ashtonchase/portable_impedance_tomography/software/ad5933/hal/README.org

* Hardware Abstraction Layer 
This folder houses the different hardware abstraction layers for device specific \(I^2C\) communication functions.
