ashtonchase/portable_impedance_tomography/documentation/final_presentation.odt

Ashton Johnson

Electrical impedance analysis is a non-invasive technique used for determining the density and composition of various materials. Regarding the human body, one dimensional analysis can determine water content, body fat, and blood glucose measurements. Using multiple electrode sets, we developed a solution to provide two dimensional (2D) tomography imaging. A portable bio-impedance tomography unit is realized using the Analog Devices AD5933 integrated circuit for measuring complex impedance, an analog front end for interfacing to the human body and analog multiplexers. We implement this as a portable device that can be accessed using Bluetooth Low Energy.
