ashtonchase/portable_impedance_tomography/documentation/report/graphics/zu.png

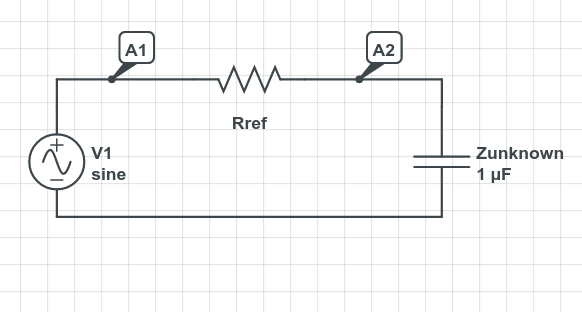
documentation/report/graphics/zu.png
