ashtonchase/portable_impedance_tomography/documentation/system_states_report/sys_diag.png

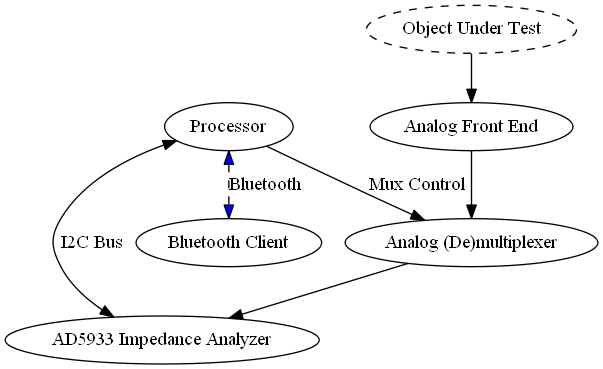
documentation/system_states_report/sys_diag.png
