ashtonchase/portable_impedance_tomography/hardware/kicad_project/portable_imedance.xlsx

Proj: | Portable Impedance Tomography |  |  |  |  |  | Board Qty: | 100
Co.: | Ashton Johnson |  |  |  |  |  | Total Cost: | $0.00 |  |  |  | $0.00 |  |  |  |  | $0.00 |  |  |  |  | $0.00 |  |  |  |  | $0.00 |  |  |  |  | $0.00 |  |  |  |  | $0.00
Date: | 2017-10-21 15:20:06 |  |  |  |  |  | Unit Cost: | $0.00 |  |  |  | 0 |  |  |  |  | 0 |  |  |  |  | 0 |  |  |  |  | 0 |  |  |  |  | 0 |  |  |  |  | 0
Global Part Info |  |  |  |  |  |  |  |  | Digi-Key |  |  |  |  | Farnell |  |  |  |  | Mouser |  |  |  |  | Newark |  |  |  |  | Rs Components |  |  |  |  | Tme
Refs | Value | Desc | Footprint | Manf | Manf# | Qty | Unit$ | Ext$ | Avail | Purch | Unit$ | Ext$ | Cat# | Avail | Purch | Unit$ | Ext$ | Cat# | Avail | Purch | Unit$ | Ext$ | Cat# | Avail | Purch | Unit$ | Ext$ | Cat# | Avail | Purch | Unit$ | Ext$ | Cat# | Avail | Purch | Unit$ | Ext$ | Cat#
C1,C2 | 0.1uF |  | Capacitors_SMD:C_0603_HandSoldering | VISHAY | VJ0603V104ZXQPW1BC | 0 | $0.00 | $0.00 |  |  |  |  |  |  |  |  |  |  | 26868 |  | $0.00 | $0.00 | 77-VJ0603V104ZXQPBC (http://www.mouser.com/Search/Refine.aspx?Keyword=VJ0603V104ZXQPW1BC%20)
C3 | 10uF |  | Capacitors_SMD:C_0603_HandSoldering | VISHAY | VJ0603V105ZXQPW1BC | 0 | $0.00 | $0.00 |  |  |  |  |  |  |  |  |  |  | 15000 |  | $0.00 | $0.00 | 77-VJ0603V105ZXQPBC (http://www.mouser.com/Search/Refine.aspx?Keyword=VJ0603V105ZXQPW1BC%20)
C5,C14,C18,C20 | 0.1u |  | Capacitors_SMD:C_0603_HandSoldering | VISHAY | VJ0603V104ZXQPW1BC | 0 | $0.00 | $0.00 |  |  |  |  |  |  |  |  |  |  | 26868 |  | $0.00 | $0.00 | 77-VJ0603V104ZXQPBC (http://www.mouser.com/Search/Refine.aspx?Keyword=VJ0603V104ZXQPW1BC%20)
C6,C10,C15,C16 | 1u |  | Capacitors_SMD:C_0603_HandSoldering | VISHAY | VJ0603V105ZXQPW1BC | 0 | $0.00 | $0.00 |  |  |  |  |  |  |  |  |  |  | 15000 |  | $0.00 | $0.00 | 77-VJ0603V105ZXQPBC (http://www.mouser.com/Search/Refine.aspx?Keyword=VJ0603V105ZXQPW1BC%20)
C8,C13 | 33n |  | Capacitors_SMD:C_0402 | VISHAY | VJ0402V333ZXQPW1BC | 0 | $0.00 | $0.00 |  |  |  |  |  |  |  |  |  |  | NonStk |  | $0.00 | $0.00 | 77-VJ0402V333ZXQPBC (http://www.mouser.com/Search/Refine.aspx?Keyword=VJ0402V333ZXQPW1BC%20)
J1-J16 | UMC |  | Connectors_Molex:Molex_Microcoaxial_RF | TE | 1909763-1 | 0 | $0.00 | $0.00 | 63580 |  | $0.00 | $0.00 | A118077CT-ND (http://www.digikey.com/product-detail/en/te-connectivity-amp-connectors/1909763-1/A118077CT-ND/4729711) | NonStk |  | $0.00 | $0.00 | 2781689 (http://it.farnell.com/webapp/wcs/stores/servlet/Search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) | 28851 |  | $0.00 | $0.00 | 571-1909763-1 (http://www.mouser.com/Search/Refine.aspx?Keyword=1909763-1%20) | NonStk |  | $0.00 | $0.00 | 62X0488 (http://www.newark.com/webapp/wcs/stores/servlet/Search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)
J17 | Conn_02x12_Odd_Even |  | Socket_Strips:Socket_Strip_Straight_2x12_Pitch2.54mm_SMD | MOLEX | 90131-0132 | 0 | $0.00 | $0.00 | NonStk |  | $0.00 | $0.00 | WM50035-24-ND (http://www.digikey.com/scripts/DkSearch/dksus.dll?WT.z_header=search_go&lang=en) |  |  |  |  |  | 777 |  | $0.00 | $0.00 | 538-90131-0132 (http://www.mouser.com/Search/Refine.aspx?Keyword=90131-0132%20) | NonStk |  | $0.00 | $0.00 | 60H4451 (http://www.newark.com/webapp/wcs/stores/servlet/Search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) | NonStk |  | $0.00 | $0.00 | 670-3477 (http://it.rs-online.com/web/c/?searchTerm=90131-0132%20)
J18 | Conn_01x03 |  |  |  | 68001-403HLF | 0 | $0.00 | $0.00 | 7623 |  | $0.00 | $0.00 | 609-3471-ND (http://www.digikey.com/scripts/DkSearch/dksus.dll?WT.z_header=search_go&lang=en) | NonStk |  |  |  | 1835553 (http://it.farnell.com/webapp/wcs/stores/servlet/Search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) | 1347 |  | $0.00 | $0.00 | 649-68001-403HLF (http://www.mouser.com/Search/../ProductDetail/Amphenol-FCI/68001-403HLF/) | 3151 |  | $0.00 | $0.00 | 56K0149 (http://www.newark.com/harwin/m20-9990346/connector-header-3-position-1row/dp/56K0149?rpsku=rel3%3A68001403HLF) | NonStk |  | $0.00 | $0.00 | 863-2747 (http://it.rs-online.com/web/c/?searchTerm=68001-403HLF%20)
J19 | Conn_02x06_Odd_Even |  | Socket_Strips:Socket_Strip_Straight_2x06_Pitch2.54mm_SMD | MOLEX | 71764-0012 | 0 | $0.00 | $0.00 | NonStk |  | $0.00 | $0.00 | WM50028-12-ND (http://www.digikey.com/scripts/DkSearch/dksus.dll?WT.z_header=search_go&lang=en) |  |  |  |  |  | 1220 |  | $0.00 | $0.00 | 538-71764-0012 (http://www.mouser.com/Search/Refine.aspx?Keyword=71764-0012%20) | NonStk |  | $0.00 | $0.00 | 01J9357 (http://www.newark.com/webapp/wcs/stores/servlet/Search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)
J20-J25 | Conn_01x02 |  | Socket_Strips:Socket_Strip_Straight_1x02_Pitch2.54mm |  | 68001-402HLF | 0 | $0.00 | $0.00 | 20294 |  | $0.00 | $0.00 | 609-3507-ND (http://www.digikey.com/scripts/DkSearch/dksus.dll?WT.z_header=search_go&lang=en) | NonStk |  | $0.00 | $0.00 | 1835033 (http://it.farnell.com/webapp/wcs/stores/servlet/Search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) | 22287 |  | $0.00 | $0.00 | 649-68001-402HLF (http://www.mouser.com/Search/../ProductDetail/Amphenol-FCI/68001-402HLF/) | NonStk |  | $0.00 | $0.00 | 75K3882 (http://www.newark.com/webapp/wcs/stores/servlet/Search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) | NonStk |  | $0.00 | $0.00 | 863-3178 (http://it.rs-online.com/web/c/?searchTerm=68001-402HLF%20)
R1,R2 | 4.7k |  | Resistors_SMD:R_0603_HandSoldering | KEMET | CRCW06034K70FKEA | 0 | $0.00 | $0.00 | NonStk |  | $0.00 | $0.00 | 541-4.70KHCT-ND (http://www.digikey.com/product-detail/en/vishay-dale/CRCW06034K70FKEA/541-4.70KHCT-ND/1179885) | NonStk |  | $0.00 | $0.00 | 1469807 (http://it.farnell.com/vishay/crcw06034k70fkea/res-film-spesso-4k7-1-0-1w-0603/dp/1469807) | NonStk |  | $0.00 | $0.00 | 71-CRCW0603-4.7K-E3 (http://www.mouser.com/Search/../ProductDetail/Vishay/CRCW06034K70FKEA/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) | NonStk |  | $0.00 | $0.00 | 52K8494 (http://www.newark.com/vishay/crcw06034k70fkea/res-thick-film-4k7-1-0-1w-0603/dp/52K8494) | 450 |  | $0.00 | $0.00 | 679-0484 (http://it.rs-online.com/web/p/resistori-smd/6790484/)
R11 | 75 |  | Resistors_SMD:R_0603_HandSoldering | KEMET | CRCW060375R0FKEA | 0 | $0.00 | $0.00 | NonStk |  | $0.00 | $0.00 | 541-75.0HCT-ND (http://www.digikey.com/product-detail/en/vishay-dale/CRCW060375R0FKEA/541-75.0HCT-ND/1179681) | NonStk |  | $0.00 | $0.00 | 1469838 (http://it.farnell.com/vishay/crcw060375r0fkea/res-film-spesso-75r-1-0-1w-0603/dp/1469838) | NonStk |  | $0.00 | $0.00 | 71-CRCW0603-75-E3 (http://www.mouser.com/Search/../ProductDetail/Vishay/CRCW060375R0FKEA/) | 692 |  | $0.00 | $0.00 | 52K8710 (http://www.newark.com/vishay/crcw060375r0fkea/res-thick-film-75r-1-0-1w-0603/dp/52K8710) | 3450 |  | $0.00 | $0.00 | 679-0699 (http://it.rs-online.com/web/p/resistori-smd/6790699/)
R12 | 10k |  | Resistors_SMD:R_0603_HandSoldering |  | CRCW060310K0FKEA | 0 | $0.00 | $0.00 | NonStk |  | $0.00 | $0.00 | 541-10.0KHCT-ND (http://www.digikey.com/product-detail/en/vishay-dale/CRCW060310K0FKEA/541-10.0KHCT-ND/1179924) | 27752 |  | $0.00 | $0.00 | 1469748 (http://it.farnell.com/vishay/crcw060310k0fkea/res-film-spesso-10k-1-0-1w-0603/dp/1469748) | NonStk |  | $0.00 | $0.00 | 71-CRCW0603-10K-E3 (http://www.mouser.com/Search/../ProductDetail/Vishay/CRCW060310K0FKEA/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) | NonStk |  | $0.00 | $0.00 | 52K8063 (http://www.newark.com/vishay/crcw060310k0fkea/res-thick-film-10k-1-0-1w-0603/dp/52K8063) | 12550 |  | $0.00 | $0.00 | 678-9667 (http://it.rs-online.com/web/p/resistori-smd/6789667/)
R3,R5,R6,R10,R15,R16 | 1k |  | Resistors_SMD:R_0603_HandSoldering | KEMET | CRCW06031K00FKEA | 0 | $0.00 | $0.00 | NonStk |  | $0.00 | $0.00 | 541-1.00KHCT-ND (http://www.digikey.com/product-detail/en/vishay-dale/CRCW06031K00FKEA/541-1.00KHCT-ND/1179809) | 840000 |  | $0.00 | $0.00 | 2122366 (http://it.farnell.com/vishay/crcw06031k00fkea/res-film-spesso-1k-1-0-1w-0603/dp/2122366) | NonStk |  | $0.00 | $0.00 | 71-CRCW0603-1.0K-E3 (http://www.mouser.com/Search/../ProductDetail/Vishay/CRCW06031K00FKEA/) | NonStk |  | $0.00 | $0.00 | 52K8016 (http://www.newark.com/vishay/crcw06031k00fkea/res-thick-film-1k-1-0-1w-0603/dp/52K8016) | NonStk |  | $0.00 | $0.00 | 678-9875 (http://it.rs-online.com/web/p/resistori-smd/6789875/) | 25000 |  | $0.00 | $0.00 | CRCW06031K00FKEA (https://www.tme.eu/en/details/crcw06031k00fkea/0603-smd-resistors/vishay/)
R4,R13,R14,R17 | 0 |  | Resistors_SMD:R_0603_HandSoldering | VISHAY | CRCW06030000Z0EA | 0 | $0.00 | $0.00 | NonStk |  | $0.00 | $0.00 | 541-0.0GCT-ND (http://www.digikey.com/product-detail/en/vishay-dale/CRCW06030000Z0EA/541-0.0GCT-ND/1179296) | NonStk |  | $0.00 | $0.00 | 1469739 (http://it.farnell.com/vishay/crcw06030000z0ea/resistor-0r-0-1w-jumper-0603-smd/dp/1469739) | NonStk |  | $0.00 | $0.00 | 71-CRCW0603-0-E3 (http://www.mouser.com/Search/../ProductDetail/Vishay/CRCW06030000Z0EA/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) | NonStk |  | $0.00 | $0.00 | 42K3627 (http://www.newark.com/vishay/crcw06030000z0ea/res-thick-film-0r-0-1w-0603-reel/dp/42K3627) | NonStk |  | $0.00 | $0.00 | 820-6736 (http://it.rs-online.com/web/p/resistori-smd/8206736/)
R7 | 75k |  | Resistors_SMD:R_0603_HandSoldering | KEMET | CRCW060375K0FKEA | 0 | $0.00 | $0.00 | NonStk |  | $0.00 | $0.00 | 541-75.0KHCT-ND (http://www.digikey.com/product-detail/en/vishay-dale/CRCW060375K0FKEA/541-75.0KHCT-ND/1180024) | 8809 |  | $0.00 | $0.00 | 2138485 (http://it.farnell.com/vishay/crcw060375k0fkea/res-film-spesso-75k-1-0-1w-0603/dp/2138485) | NonStk |  | $0.00 | $0.00 | 71-CRCW0603-75K-E3 (http://www.mouser.com/Search/../ProductDetail/Vishay/CRCW060375K0FKEA/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) | 795 |  | $0.00 | $0.00 | 52K8708 (http://www.newark.com/vishay/crcw060375k0fkea/res-thick-film-75k-1-0-1w-0603/dp/52K8708) | NonStk |  |  |  | 679-0695 (http://it.rs-online.com/web/p/resistori-smd/6790695/)
R8,R9 | 1M |  | Resistors_SMD:R_0603_HandSoldering | KEMET | CRCW06031M00FKEA | 0 | $0.00 | $0.00 | 671 |  | $0.00 | $0.00 | 541-1.00MHCT-ND (http://www.digikey.com/product-detail/en/vishay-dale/CRCW06031M00FKEA/541-1.00MHCT-ND/1180152) | NonStk |  | $0.00 | $0.00 | 1469746 (http://it.farnell.com/vishay/crcw06031m00fkea/res-film-spesso-1m-1-0-1w-0603/dp/1469746) | NonStk |  | $0.00 | $0.00 | 71-CRCW0603-1.0M-E3 (http://www.mouser.com/Search/../ProductDetail/Vishay/CRCW06031M00FKEA/) | 11295 |  | $0.00 | $0.00 | 52K8053 (http://www.newark.com/vishay/crcw06031m00fkea/res-thick-film-1m-1-0-1w-0603/dp/52K8053) | 4150 |  | $0.00 | $0.00 | 678-9932 (http://it.rs-online.com/web/p/resistori-smd/6789932/) | 19600 |  | $0.00 | $0.00 | CRCW06031M00FKEA (https://www.tme.eu/en/details/crcw06031m00fkea/0603-smd-resistors/vishay/)
RV1 | 20K |  | Potentiometers:Potentiometer_Trimmer_Bourns_3214W | BOURNS | 3214W-2-203E | 0 | $0.00 | $0.00 | NonStk |  | $0.00 | $0.00 | 3214W-2-203E-ND (http://www.digikey.com/scripts/DkSearch/dksus.dll?WT.z_header=search_go&lang=en) |  |  |  |  |  | 38 |  | $0.00 | $0.00 | 652-3214W-2-203E (http://www.mouser.com/Search/Refine.aspx?Keyword=3214W-2-203E%20)
U2 | AD5933 |  | Housings_SSOP:SSOP-16_5.3x6.2mm_Pitch0.65mm | Analog Devices | AD5933YRSZ | 0 | $0.00 | $0.00 | 3890 |  | $0.00 | $0.00 | AD5933YRSZ-ND (http://www.digikey.com/product-detail/en/analog-devices-inc/AD5933YRSZ/AD5933YRSZ-ND/756602) | NonStk |  | $0.00 | $0.00 | 1438950 (http://it.farnell.com/analog-devices/ad5933yrsz/ic-convertitore-impedenza-12bit/dp/1438950) | NonStk |  | $0.00 | $0.00 | 584-AD5933YRSZ (http://www.mouser.com/Search/../ProductDetail/Analog-Devices/AD5933YRSZ/) | 2 |  | $0.00 | $0.00 | 06M5088 (http://www.newark.com/webapp/wcs/stores/servlet/Search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) | 3 |  | $0.00 | $0.00 | 709-4816 (http://it.rs-online.com/web/p/sintetizzatori-digitali/7094816/)
U3,U9 | ADG1209 |  | Housings_SSOP:TSSOP-16_4.4x5mm_Pitch0.65mm | Analog Devices | ADG1209YRUZ | 0 | $0.00 | $0.00 | 878 |  | $0.00 | $0.00 | ADG1209YRUZ-ND (http://www.digikey.com/product-detail/en/analog-devices-inc/ADG1209YRUZ/ADG1209YRUZ-ND/2606636) | 5 |  | $0.00 | $0.00 | 2377065 (http://it.farnell.com/webapp/wcs/stores/servlet/Search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) | 1197 |  | $0.00 | $0.00 | 584-ADG1209YRUZ (http://www.mouser.com/Search/../ProductDetail/Analog-Devices/ADG1209YRUZ/) | NonStk |  | $0.00 | $0.00 | 23X5938 (http://www.newark.com/webapp/wcs/stores/servlet/Search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) | 82 |  | $0.00 | $0.00 | 759-0288 (http://it.rs-online.com/web/c/?searchTerm=ADG1209YRUZ%20)
U5 | LDS3985M25R |  | TO_SOT_Packages_SMD:TSOT-23-5 | ST Microelectronics | LDS3985M25R | 0 | $0.00 | $0.00 | 11029 |  | $0.00 | $0.00 | 497-6147-1-ND (http://www.digikey.com/product-detail/en/stmicroelectronics/LDS3985M25R/497-6147-1-ND/1654069) |  |  |  |  |  | 2393 |  | $0.00 | $0.00 | 511-LDS3985M25R (http://www.mouser.com/Search/Refine.aspx?Keyword=LDS3985M25R%20) | NonStk |  | $0.00 | $0.00 | 56P7686 (http://www.newark.com/webapp/wcs/stores/servlet/Search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)
U6,U7 | OPA2836 |  | Housings_SSOP:TSSOP-10_3x3mm_Pitch0.5mm | TEXAS INSTRUMENTS | OPA2836IDGS | 0 | $0.00 | $0.00 |  |  |  |  |  | NonStk |  | $0.00 | $0.00 | 2379228 (http://it.farnell.com/texas-instruments/opa2836idgsevm/mod-val-amplificatore-op/dp/2379228) | 110 |  | $0.00 | $0.00 | 595-OPA2836IDGS (http://www.mouser.com/Search/../ProductDetail/Texas-Instruments/OPA2836IDGS/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) | NonStk |  | $0.00 | $0.00 | 64T3761 (http://www.newark.com/webapp/wcs/stores/servlet/Search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)
U8 | AD8130 |  | Housings_SOIC:SO-8_5.3x6.2mm_Pitch1.27mm | Analog Devices | AD8130ARZ | 0 | $0.00 | $0.00 | 2985 |  | $0.00 | $0.00 | AD8130ARZ-ND (http://www.digikey.com/product-detail/en/analog-devices-inc/AD8130ARZ/AD8130ARZ-ND/751140) | 367 |  | $0.00 | $0.00 | 9604278 (http://it.farnell.com/webapp/wcs/stores/servlet/Search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) | 639 |  | $0.00 | $0.00 | 584-AD8130ARZ (http://www.mouser.com/Search/../ProductDetail/Analog-Devices/AD8130ARZ/?qs=sGAEpiMZZMv9Q1JI0Mo%2ftZTekRn6kgHV) | 29 |  | $0.00 | $0.00 | 59K6397 (http://www.newark.com/webapp/wcs/stores/servlet/Search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) | 26 |  | $0.00 | $0.00 | 497-2268 (http://it.rs-online.com/web/p/ricevitori-differenziali/4972268/) | 93 |  | $0.00 | $0.00 | AD8130ARZ (https://www.tme.eu/en/details/ad8130arz/smd-operational-amplifiers/analog-devices/)
 |  |  |  |  |  |  |  |  |  | 0 |  |  |  |  | 0 |  |  |  |  | 0 |  |  |  |  | 0 |  |  |  |  | 0 |  |  |  |  | 0
 |  |  |  |  |  |  |  |  |  | 0 | 0 | 0 |  |  | 0 | 0 | 0 |  |  | 0 | 0 | 0 |  |  | 0 | 0 | 0 |  |  | 0 | 0 | 0 |  |  | 0 | 0 | 0
 |  |  |  |  |  |  |  |  |  | 0 | 0 | 0 |  |  | 0 | 0 | 0 |  |  | 0 | 0 | 0 |  |  | 0 | 0 | 0 |  |  | 0 | 0 | 0 |  |  | 0 | 0 | 0
 |  |  |  |  |  |  |  |  |  | 0 | 0 | 0 |  |  | 0 | 0 | 0 |  |  | 0 | 0 | 0 |  |  | 0 | 0 | 0 |  |  | 0 | 0 | 0 |  |  | 0 | 0 | 0
 |  |  |  |  |  |  |  |  |  | 0 | 0 | 0 |  |  | 0 | 0 | 0 |  |  | 0 | 0 | 0 |  |  | 0 | 0 | 0 |  |  | 0 | 0 | 0 |  |  | 0 | 0 | 0
 |  |  |  |  |  |  |  |  |  | 0 | 0 | 0 |  |  | 0 | 0 | 0 |  |  | 0 | 0 | 0 |  |  | 0 | 0 | 0 |  |  | 0 | 0 | 0 |  |  | 0 | 0 | 0
 |  |  |  |  |  |  |  |  |  | 0 | 0 | 0 |  |  | 0 | 0 | 0 |  |  | 0 | 0 | 0 |  |  | 0 | 0 | 0 |  |  | 0 | 0 | 0 |  |  | 0 | 0 | 0
 |  |  |  |  |  |  |  |  |  | 0 | 0 | 0 |  |  | 0 | 0 | 0 |  |  | 0 | 0 | 0 |  |  | 0 | 0 | 0 |  |  | 0 | 0 | 0 |  |  | 0 | 0 | 0
 |  |  |  |  |  |  |  |  |  | 0 | 0 | 0 |  |  | 0 | 0 | 0 |  |  | 0 | 0 | 0 |  |  | 0 | 0 | 0 |  |  | 0 | 0 | 0 |  |  | 0 | 0 | 0
 |  |  |  |  |  |  |  |  |  | 0 | 0 | 0 |  |  | 0 | 0 | 0 |  |  | 0 | 0 | 0 |  |  | 0 | 0 | 0 |  |  | 0 | 0 | 0 |  |  | 0 | 0 | 0
 |  |  |  |  |  |  |  |  |  | 0 | 0 | 0 |  |  | 0 | 0 | 0 |  |  | 0 | 0 | 0 |  |  | 0 | 0 | 0 |  |  | 0 | 0 | 0 |  |  | 0 | 0 | 0
 |  |  |  |  |  |  |  |  |  | 0 | 0 | 0 |  |  | 0 | 0 | 0 |  |  | 0 | 0 | 0 |  |  | 0 | 0 | 0 |  |  | 0 | 0 | 0 |  |  | 0 | 0 | 0
 |  |  |  |  |  |  |  |  |  | 0 | 0 | 0 |  |  | 0 | 0 | 0 |  |  | 0 | 0 | 0 |  |  | 0 | 0 | 0 |  |  | 0 | 0 | 0 |  |  | 0 | 0 | 0
 |  |  |  |  |  |  |  |  |  | 0 | 0 | 0 |  |  | 0 | 0 | 0 |  |  | 0 | 0 | 0 |  |  | 0 | 0 | 0 |  |  | 0 | 0 | 0 |  |  | 0 | 0 | 0
 |  |  |  |  |  |  |  |  |  | 0 | 0 | 0 |  |  | 0 | 0 | 0 |  |  | 0 | 0 | 0 |  |  | 0 | 0 | 0 |  |  | 0 | 0 | 0 |  |  | 0 | 0 | 0
 |  |  |  |  |  |  |  |  |  | 0 | 0 | 0 |  |  | 0 | 0 | 0 |  |  | 0 | 0 | 0 |  |  | 0 | 0 | 0 |  |  | 0 | 0 | 0 |  |  | 0 | 0 | 0
 |  |  |  |  |  |  |  |  |  | 0 | 0 | 0 |  |  | 0 | 0 | 0 |  |  | 0 | 0 | 0 |  |  | 0 | 0 | 0 |  |  | 0 | 0 | 0 |  |  | 0 | 0 | 0
 |  |  |  |  |  |  |  |  |  | 0 | 0 | 0 |  |  | 0 | 0 | 0 |  |  | 0 | 0 | 0 |  |  | 0 | 0 | 0 |  |  | 0 | 0 | 0 |  |  | 0 | 0 | 0
 |  |  |  |  |  |  |  |  |  | 0 | 0 | 0 |  |  | 0 | 0 | 0 |  |  | 0 | 0 | 0 |  |  | 0 | 0 | 0 |  |  | 0 | 0 | 0 |  |  | 0 | 0 | 0
 |  |  |  |  |  |  |  |  |  | 0 | 0 | 0 |  |  | 0 | 0 | 0 |  |  | 0 | 0 | 0 |  |  | 0 | 0 | 0 |  |  | 0 | 0 | 0 |  |  | 0 | 0 | 0
 |  |  |  |  |  |  |  |  |  | 0 | 0 | 0 |  |  | 0 | 0 | 0 |  |  | 0 | 0 | 0 |  |  | 0 | 0 | 0 |  |  | 0 | 0 | 0 |  |  | 0 | 0 | 0
 |  |  |  |  |  |  |  |  |  | 0 | 0 | 0 |  |  | 0 | 0 | 0 |  |  | 0 | 0 | 0 |  |  | 0 | 0 | 0 |  |  | 0 | 0 | 0 |  |  | 0 | 0 | 0
 |  |  |  |  |  |  |  |  |  | 0 | 0 | 0 |  |  | 0 | 0 | 0 |  |  | 0 | 0 | 0 |  |  | 0 | 0 | 0 |  |  | 0 | 0 | 0 |  |  | 0 | 0 | 0
 |  |  |  |  |  |  |  |  |  | 0 | 0 | 0 |  |  | 0 | 0 | 0 |  |  | 0 | 0 | 0 |  |  | 0 | 0 | 0 |  |  | 0 | 0 | 0 |  |  | 0 | 0 | 0
