ashtonchase/portable_impedance_tomography/documentation/graphics/board_assembled_bottom.jpg

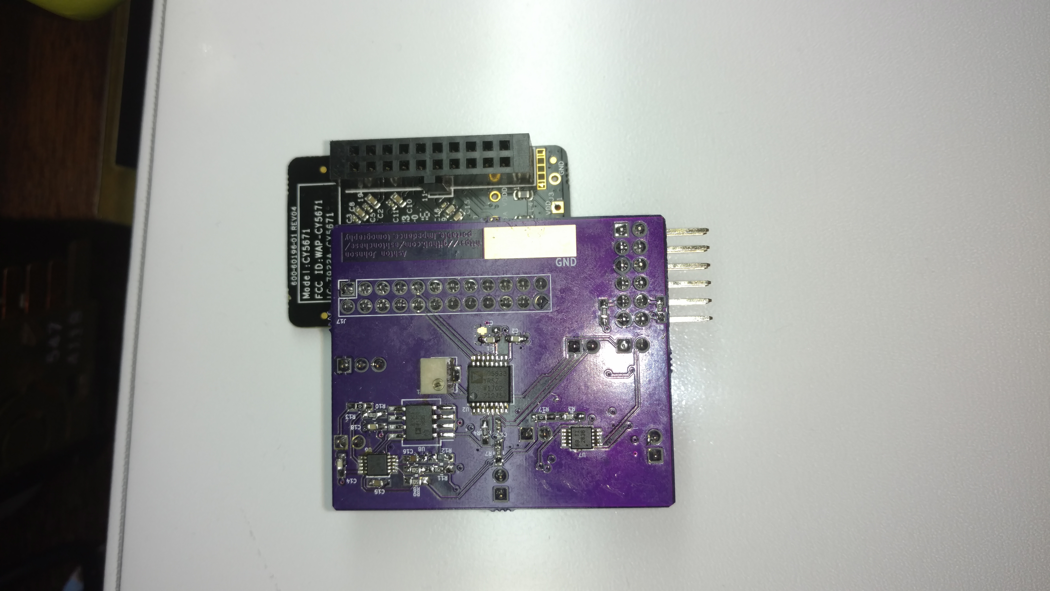
documentation/graphics/board_assembled_bottom.jpg
