ashtonchase/portable_impedance_tomography/documentation/graphics/board_assembled_top.jpg

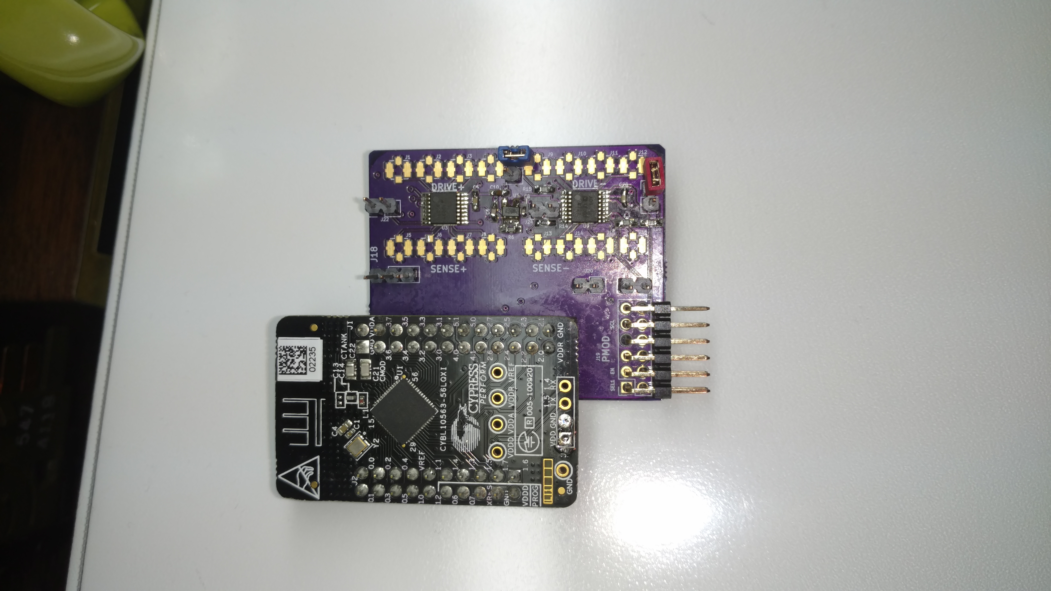
documentation/graphics/board_assembled_top.jpg
