ashtonchase/portable_impedance_tomography/testing/5v0_pwr.png

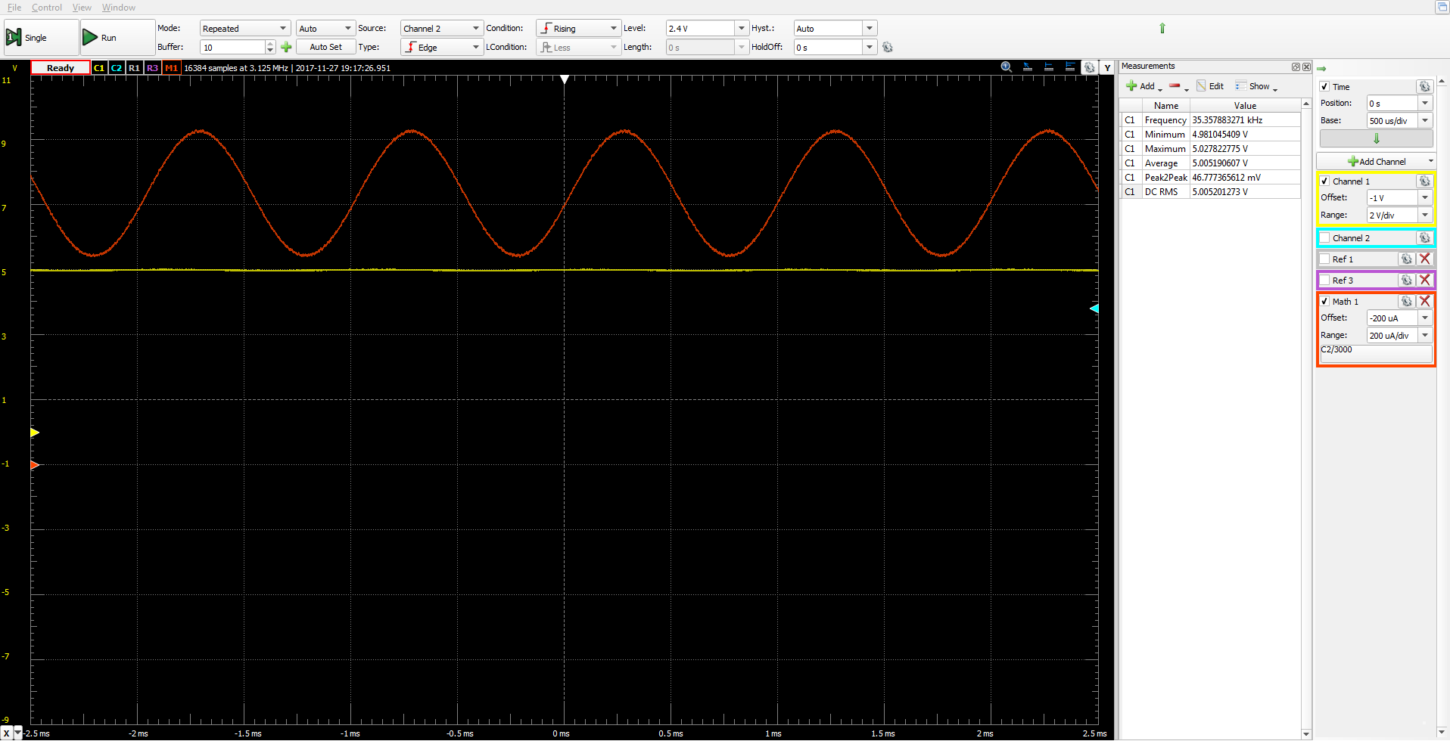
testing/5v0_pwr.png
