ashtonchase/portable_impedance_tomography/testing/ad5933out_afeout_3k_res.png

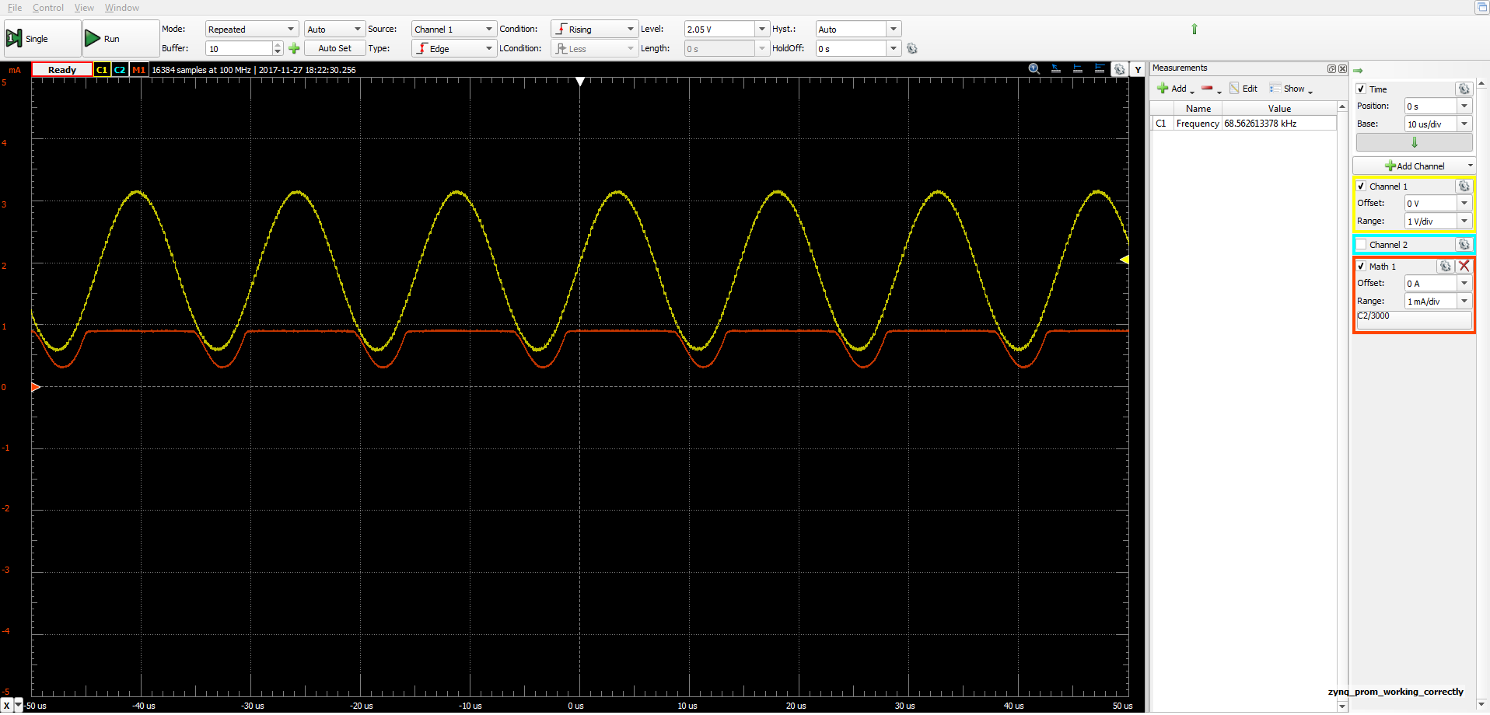
testing/ad5933out_afeout_3k_res.png
