ashtonchase/portable_impedance_tomography/testing/usb_pwr_from_baseboard.png

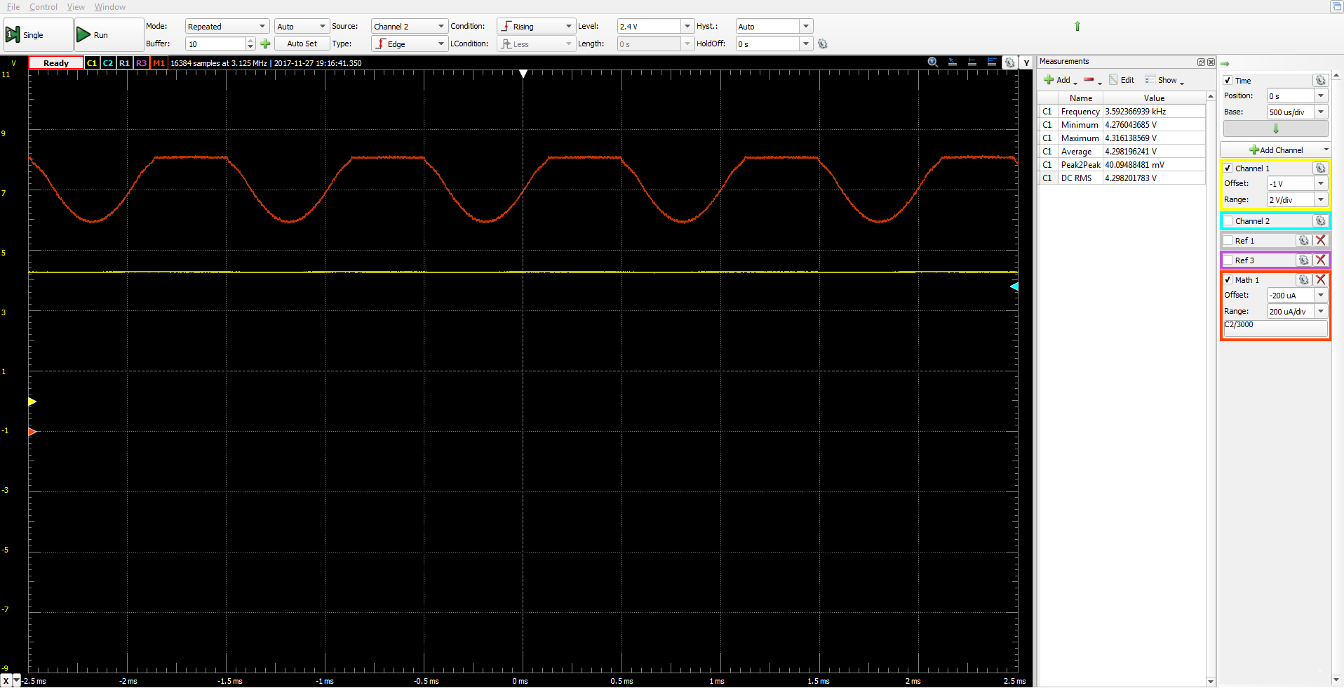
testing/usb_pwr_from_baseboard.png
