ashtonchase/portable_impedance_tomography/documentation/schematic/portable_impedance.pdf

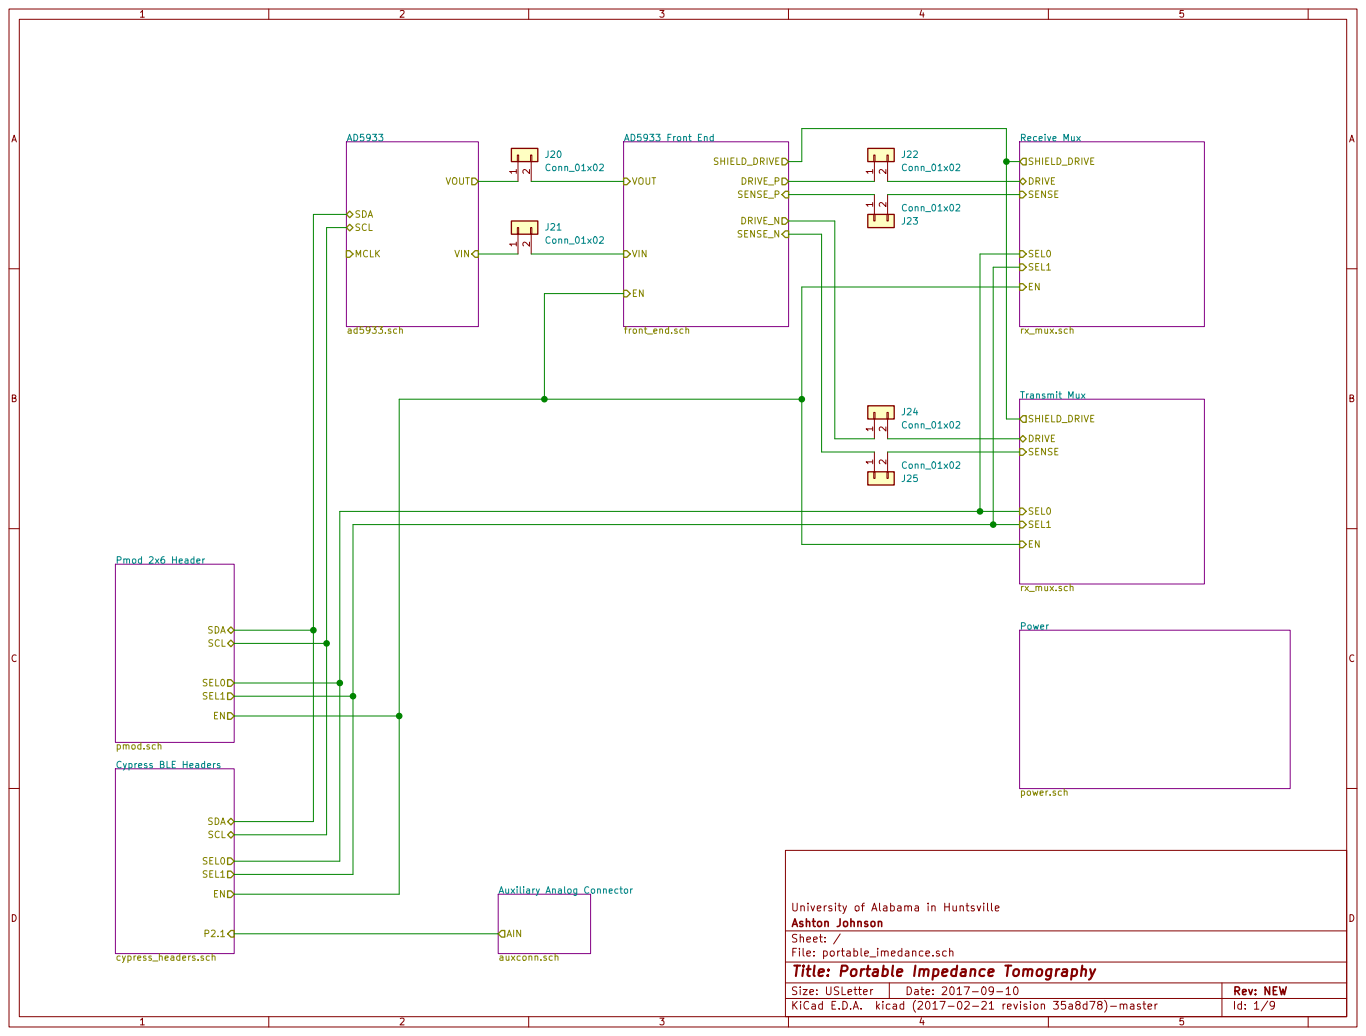
[picture p38: page 1]

Auxiliary Analog Connector auxconn.sch AIN

File: portable_imedance.sch Sheet: / Ashton Johnson University of Alabama in Huntsville

Id: 1/9 Title: Portable Impedance Tomography

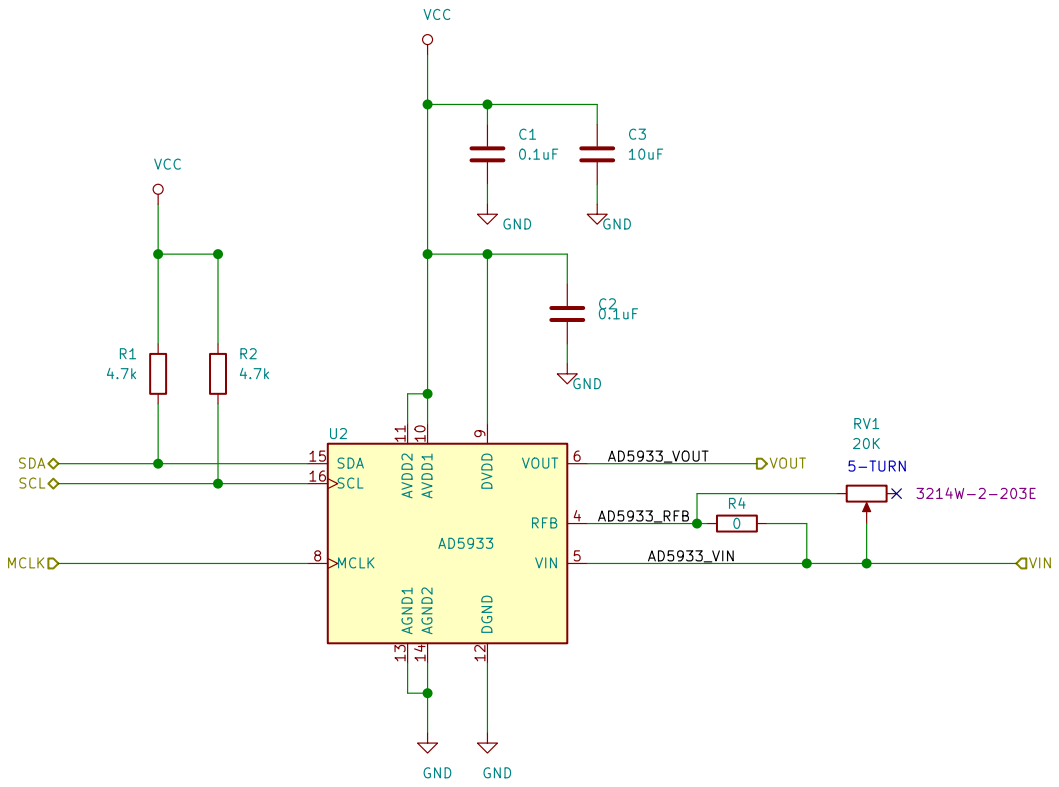
[picture p39: page 2]

File: ad5933.sch Sheet: /AD5933/ Ashton Johnson University of Alabama in Huntsville

Id: 2/9 Title: Portable Impedance Tomography

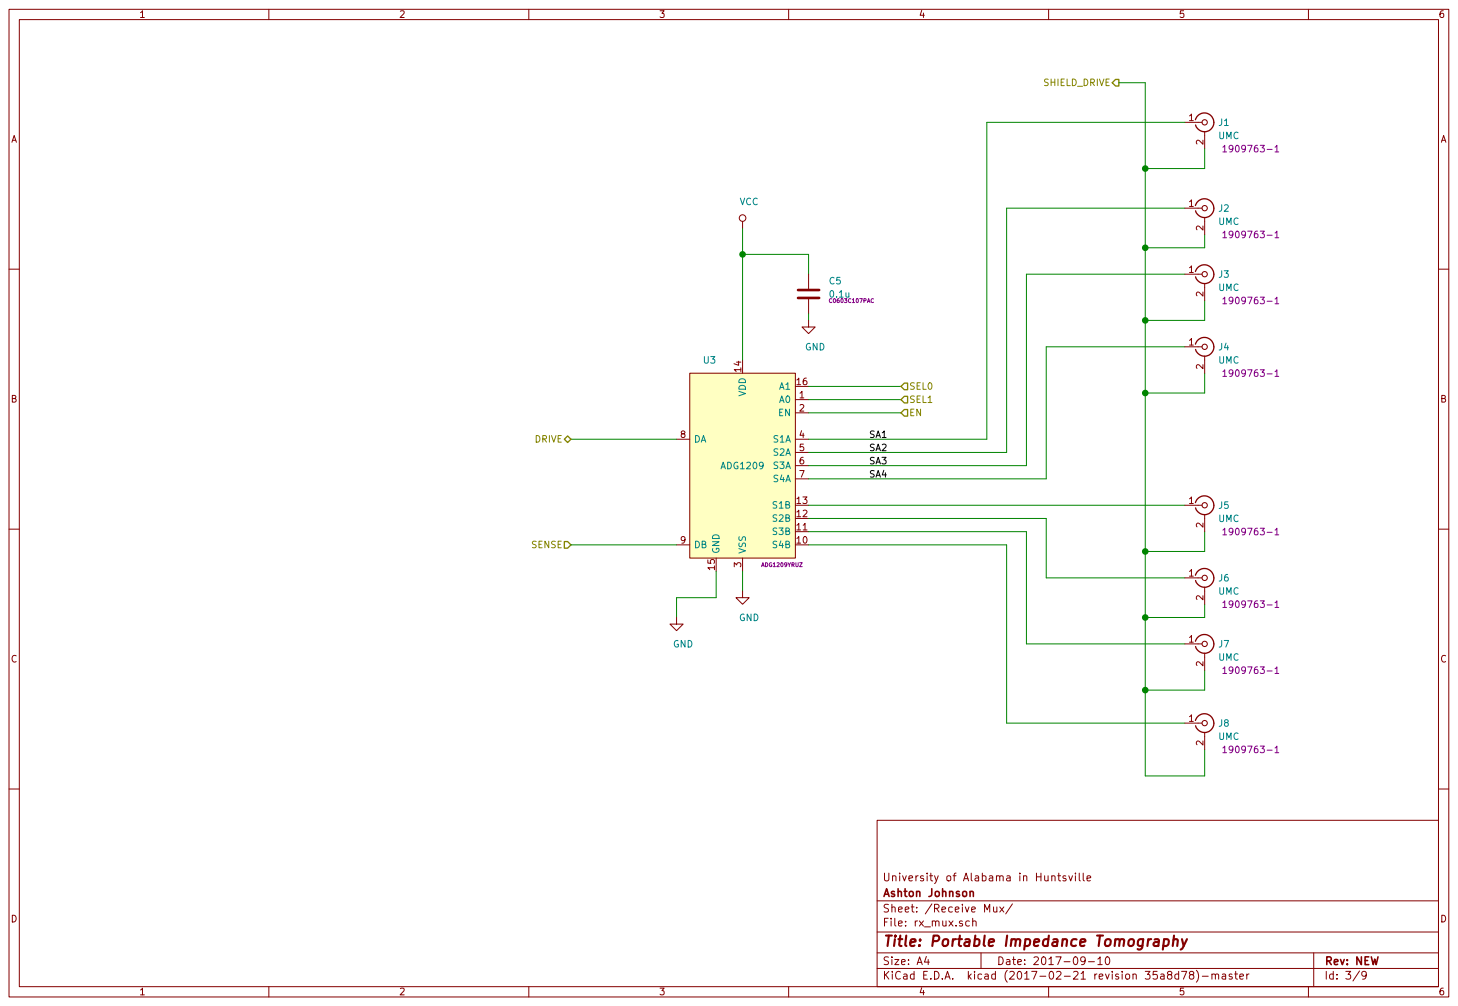
[picture p40: page 3]

File: rx_mux.sch Sheet: /Receive Mux/ Ashton Johnson University of Alabama in Huntsville

Id: 3/9 Title: Portable Impedance Tomography

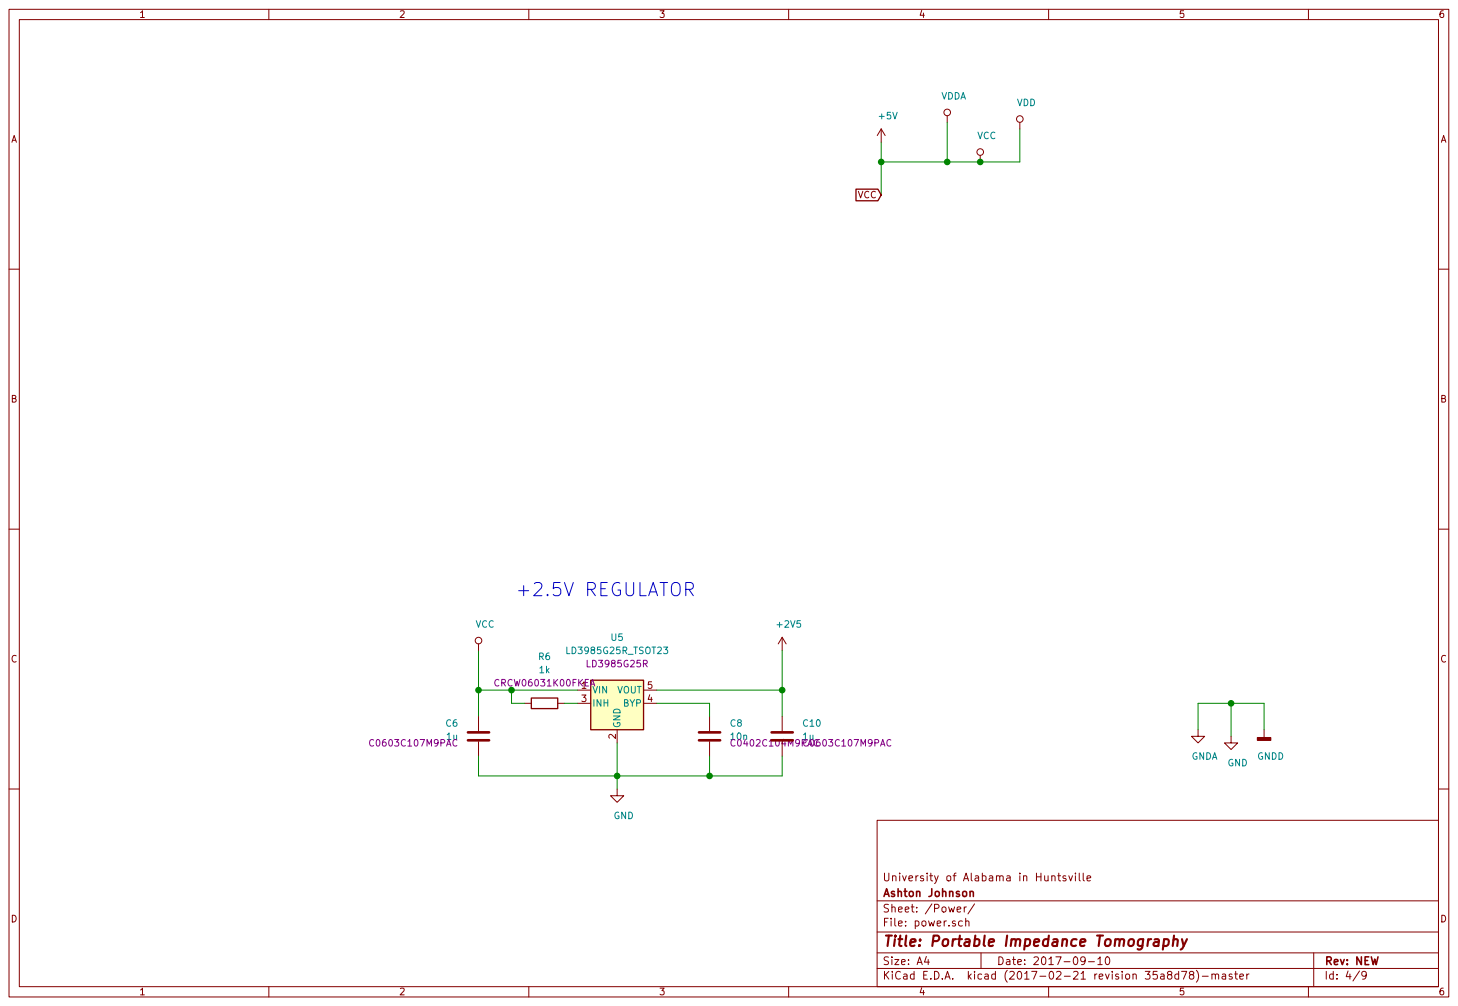
[picture p41: page 4]

Id: 4/9 Title: Portable Impedance Tomography

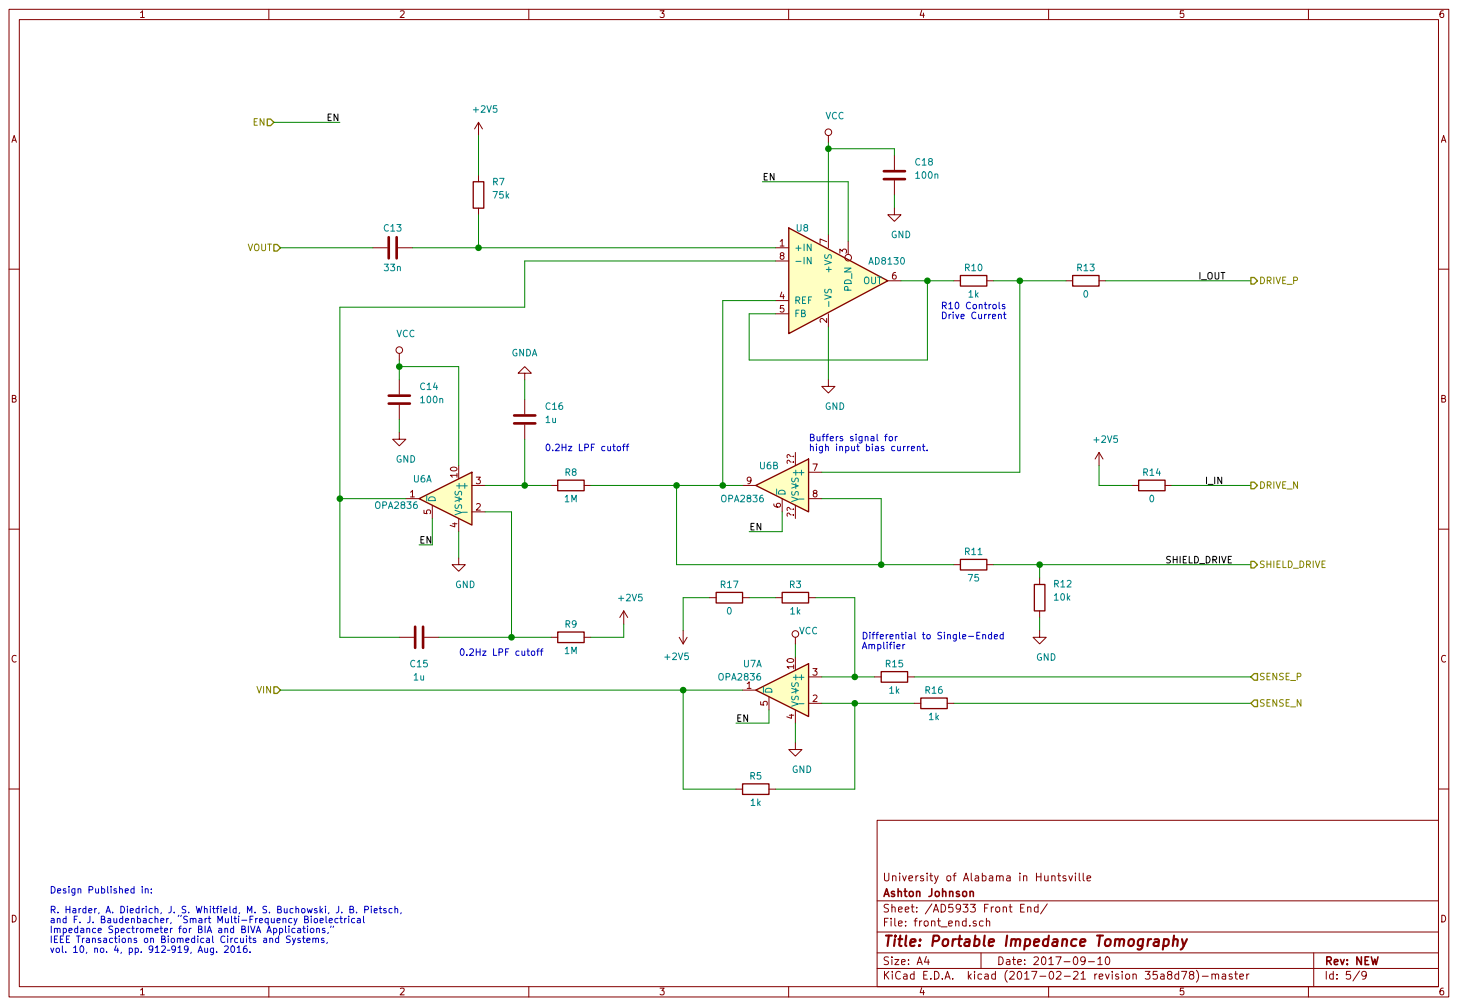
[picture p42: page 5]

3 REF 4 FB 5 OUT 6 +VS

SHIELD_DRIVE Design Published in: R. Harder, A. Diedrich, J. S. Whitfield, M. S. Buchowski, J. B. Pietsch, and F. J. Baudenbacher, Smart Multi-Frequency Bioelectrical

File: front_end.sch Sheet: /AD5933 Front End/ Ashton Johnson University of Alabama in Huntsville

Id: 5/9 Title: Portable Impedance Tomography

Impedance Spectrometer for BIA and BIVA Applications,
IEEE Transactions on Biomedical Circuits and Systems,

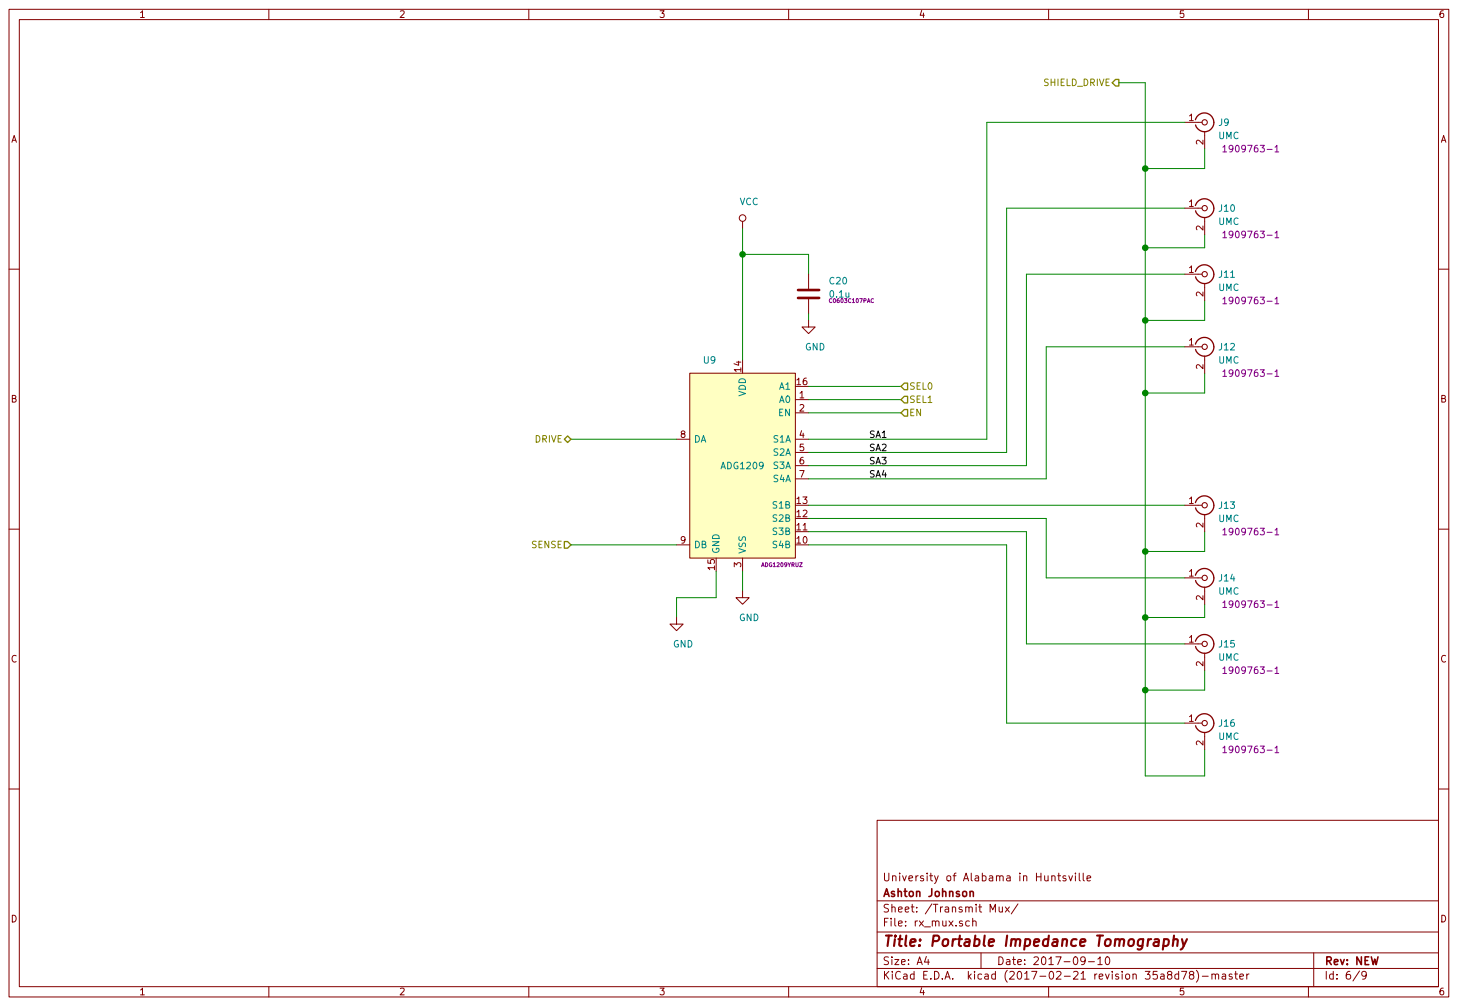
[picture p43: page 6]

File: rx_mux.sch Sheet: /Transmit Mux/ Ashton Johnson University of Alabama in Huntsville

Id: 6/9 Title: Portable Impedance Tomography

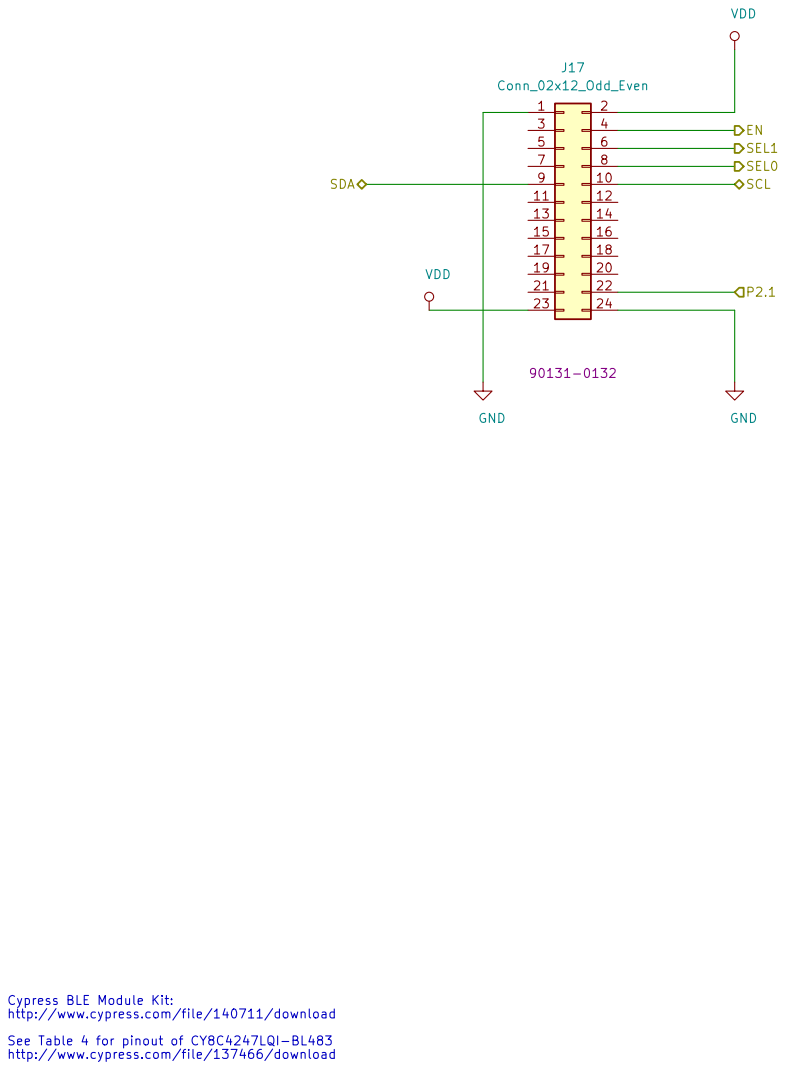
[picture p44: page 7]

Cypress BLE Module Kit:
http://www.cypress.com/file/140711/download
See Table 4 for pinout of CY8C4247LQI-BL483
http://www.cypress.com/file/137466/download

Sheet: /Cypress BLE Headers/
File: cypress_headers.sch
Id: 7/9 Title:

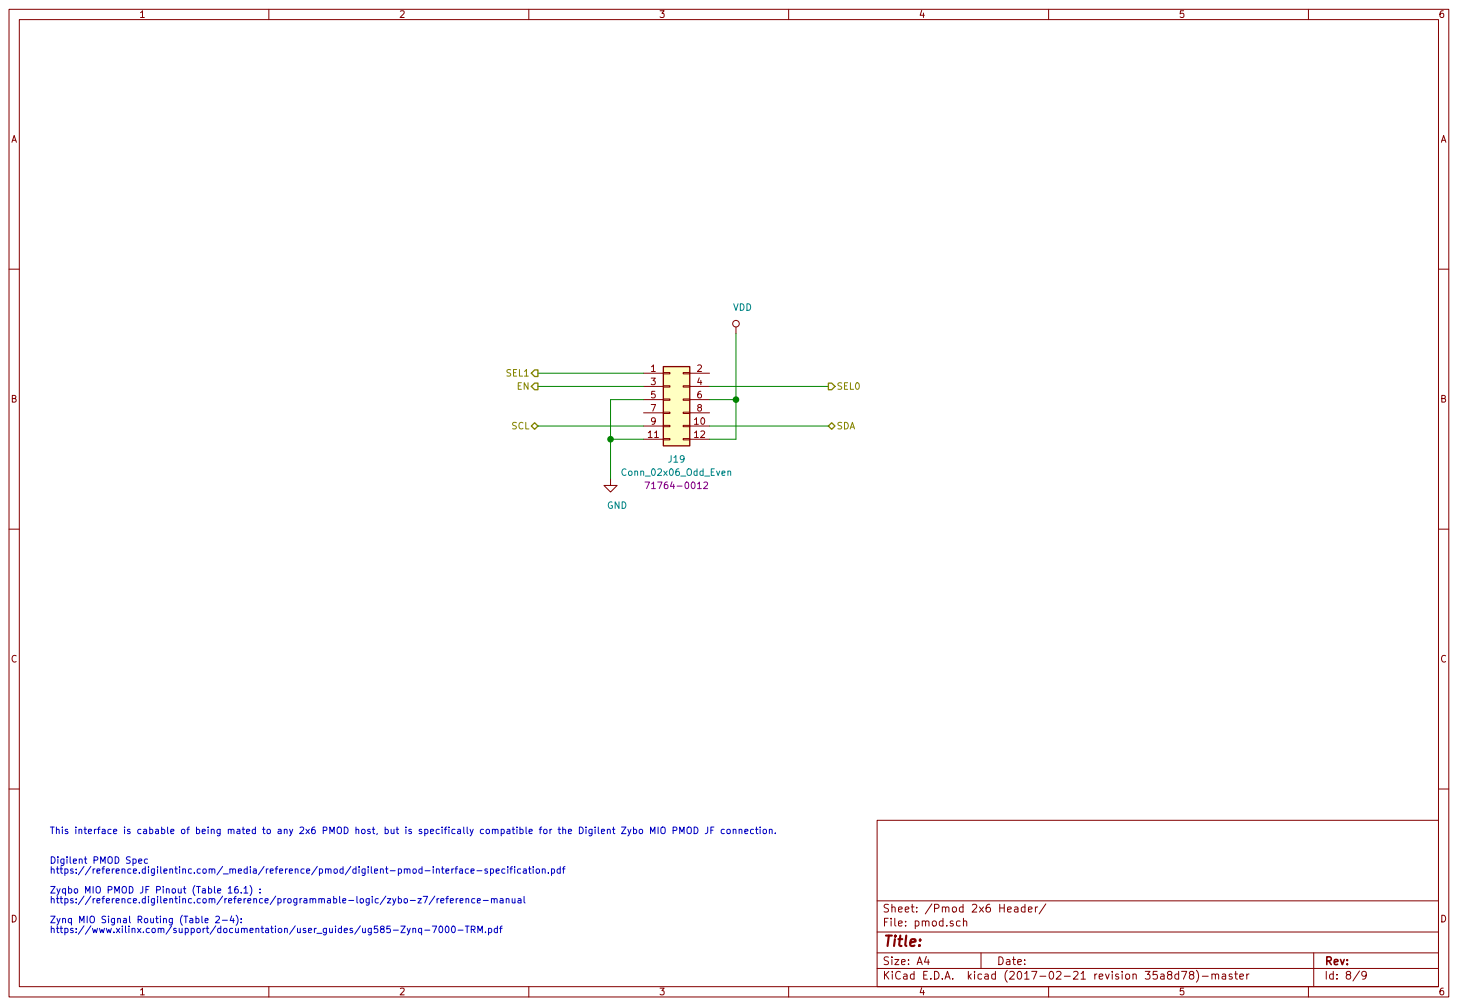
[picture p45: page 8]

File: pmod.sch Sheet: /Pmod 2x6 Header/ This interface is cabable of being mated to any 2x6 PMOD host, but is specifically compatible for the Digilent Zybo MIO PMOD JF connection.

Digilent PMOD Spec
https://reference.digilentinc.com/_media/reference/pmod/digilent-pmod-interface-specification.pdf
Zyqbo MIO PMOD JF Pinout (Table 16.1) :
https://reference.digilentinc.com/reference/programmable-logic/zybo-z7/reference-manual
Zynq MIO Signal Routing (Table 2-4):

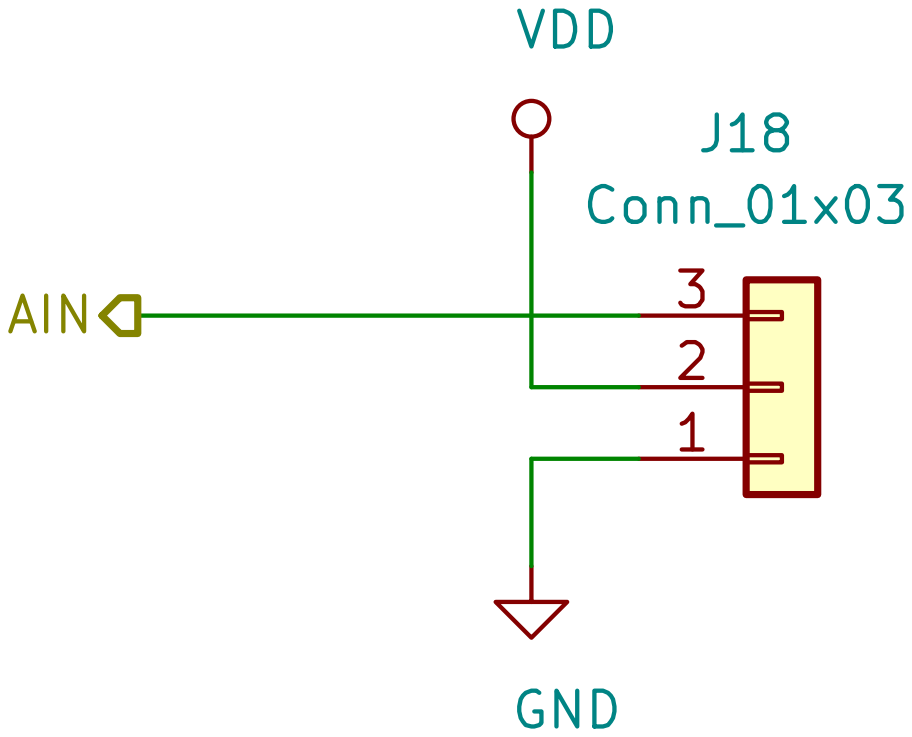
[picture p46: page 9]

Id: 9/9 Title: File: auxconn.sch Sheet: /Auxiliary Analog Connector/
