ashtonchase/portable_impedance_tomography/hardware/kicad_project/portable_imedance.kicad_pcb

## KiCad design hardware/kicad_project/portable_imedance.kicad_pcb (2017-10-18)

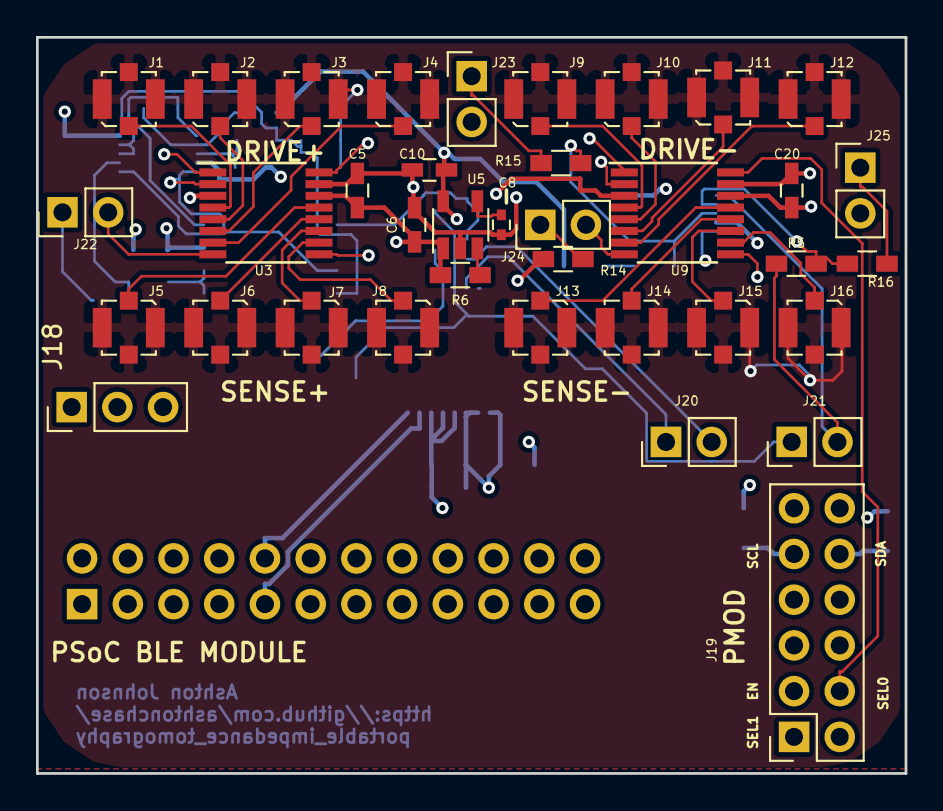
[picture p47: board portable_imedance.kicad_pcb from above]

Board: 4 copper layers, 48.3 x 40.9 mm, 63 parts (0 on the bottom side), 51 nets.

Parts:
C1, C2: 0.1uF; C_0603_HandSoldering
C3: 10uF; C_0603_HandSoldering
C5, C20: 0.1u; C_0603_HandSoldering
C6, C10, C15, C16: 1u; C_0603_HandSoldering
C8: 10n; C_0402
C13: 33n; C_0402
C14, C18: 100n; C_0603_HandSoldering
J1, J2, J3, J4, J5, J6, J7, J8, J9, J10, J11, J12, J13, J14, J15, J16: UMC; Molex_Microcoaxial_RF
J17: Conn_02x12_Odd_Even; Socket_Strip_Straight_2x12_Pitch2.54mm
J18: Conn_01x03; Socket_Strip_Straight_1x03_Pitch2.54mm
J19: Conn_02x06_Odd_Even; Socket_Strip_Straight_2x06_Pitch2.54mm
J20, J21, J22, J23, J24, J25: Conn_01x02; Socket_Strip_Straight_1x02_Pitch2.54mm
R1, R2: 4.7k; R_0603_HandSoldering
R3, R5, R6, R10, R15, R16: 1k; R_0603_HandSoldering
R4, R13, R14, R17: 0; R_0603_HandSoldering
R7: 75k; R_0603_HandSoldering
R8, R9: 1M; R_0603_HandSoldering
R11: 75; R_0603_HandSoldering
R12: 10k; R_0603_HandSoldering
RV1: 20K; Potentiometer_Trimmer_Bourns_3214W
U2: AD5933; SSOP-16_5.3x6.2mm_Pitch0.65mm
U3, U9: ADG1209; TSSOP-16_4.4x5mm_Pitch0.65mm
U5: LD3985G25R_TSOT23; TSOT-23-5
U6, U7: OPA2836; TSSOP-10_3x3mm_Pitch0.5mm
U8: AD8130; SO-8_5.3x6.2mm_Pitch1.27mm

Connections:
+2V5: C10.1, R7.1, R9.1, R14.2, R17.2, U5.5
/AD5933 Front End/DRIVE_N: J24.1, R14.1
/AD5933 Front End/DRIVE_P: J22.1, R13.1
/AD5933 Front End/EN: J17.4, J19.3, U3.2, U6.5, U6.6, U7.5, U8.3, U9.2
/AD5933 Front End/SENSE_N: J25.1, R16.1
/AD5933 Front End/SENSE_P: J23.1, R15.1
/AD5933 Front End/SHIELD_DRIVE: J1.2, J2.2, J3.2, J4.2, J5.2, J6.2, J7.2, J8.2, J9.2, J10.2, J11.2, J12.2, J13.2, J14.2, J15.2, J16.2, R11.1, R12.2
/AD5933 Front End/VIN: J21.2, R5.2, U7.1
/AD5933 Front End/VOUT: C13.2, J20.2
/AD5933/AD5933_RFB: R4.2, RV1.3, U2.4
/AD5933/SCL: J17.10, J19.9, R2.2, U2.16
/AD5933/SDA: J17.9, J19.10, R1.2, U2.15
/AD5933/VIN: J21.1, R4.1, RV1.2, U2.5
/AD5933/VOUT: J20.1, U2.6
/Auxiliary Analog Connector/AIN: J17.22, J18.3
/Cypress BLE Headers/SEL0: J17.8, J19.4, U3.16, U9.16
/Cypress BLE Headers/SEL1: J17.6, J19.1, U3.1, U9.1
/Receive Mux/DRIVE: J22.2, U3.8
/Receive Mux/SA1: J1.1, U3.4
/Receive Mux/SA2: J2.1, U3.5
/Receive Mux/SA3: J3.1, U3.6
/Receive Mux/SA4: J4.1, U3.7
/Receive Mux/SENSE: J23.2, U3.9
/Transmit Mux/DRIVE: J24.2, U9.8
/Transmit Mux/SA1: J9.1, U9.4
/Transmit Mux/SA2: J10.1, U9.5
/Transmit Mux/SA3: J11.1, U9.6
/Transmit Mux/SA4: J12.1, U9.7
/Transmit Mux/SENSE: J25.2, U9.9
GND: C1.2, C2.2, C3.2, C5.2, C6.2, C8.2, C10.2, C14.2, C16.1, C18.2, C20.2, J17.1, J17.24, J18.1, J19.5, J19.11, R12.1, U2.12, U2.13, U2.14, U3.3, U3.15, U5.2, U6.4, U7.4, U8.2, U9.3, U9.15
unnamed: C8.1, U5.4
unnamed: C13.1, R7.2, U8.1
unnamed: C15.1, R9.2, U6.2
unnamed: C15.2, U6.1, U8.8
unnamed: C16.2, R8.2, U6.3
unnamed: J5.1, U3.13
unnamed: J6.1, U3.12
unnamed: J7.1, U3.11
unnamed: J8.1, U3.10
unnamed: J13.1, U9.13
unnamed: J14.1, U9.12
unnamed: J15.1, U9.11
unnamed: J16.1, U9.10
unnamed: R6.1, U5.3
unnamed: R10.1, R13.2, U6.7
unnamed: R10.2, U8.5, U8.6
unnamed: R8.1, R11.2, U6.8, U6.9, U8.4
unnamed: R3.1, R15.2, U7.3
unnamed: R5.1, R16.2, U7.2
unnamed: R3.2, R17.1
VCC: C1.1, C2.1, C3.1, C5.1, C6.1, C14.1, C18.1, C20.1, J17.2, J17.23, J18.2, J19.6, J19.12, R1.1, R2.1, R6.2, U2.9, U2.10, U2.11, U3.14, U5.1, U6.10, U7.10, U8.7, U9.14
