ashtonchase/portable_impedance_tomography/software/PSOC/Workspace/AD5933_PSOC.cydsn/main.h

/******************************************************************************
* Project Name		: AN91162
* File Name			: main.h
* Version 			: 1.0
* Device Used		: CY8C4247LQI-BL483
* Software Used		: PSoC Creator 3.3 SP1
* Compiler    		: ARM GCC 4.9.3, ARM MDK Generic
* Related Hardware	: CY8CKIT-042-BLE Bluetooth Low Energy Pioneer Kit 
* Owner             : ROIT
*
********************************************************************************
* Copyright (2014), Cypress Semiconductor Corporation. All Rights Reserved.
********************************************************************************
* This software is owned by Cypress Semiconductor Corporation (Cypress)
* and is protected by and subject to worldwide patent protection (United
* States and foreign), United States copyright laws and international treaty
* provisions. Cypress hereby grants to licensee a personal, non-exclusive,
* non-transferable license to copy, use, modify, create derivative works of,
* and compile the Cypress Source Code and derivative works for the sole
* purpose of creating custom software in support of licensee product to be
* used only in conjunction with a Cypress integrated circuit as specified in
* the applicable agreement. Any reproduction, modification, translation,
* compilation, or representation of this software except as specified above 
* is prohibited without the express written permission of Cypress.
*
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
* Use of this Software may be limited by and subject to the applicable Cypress
* software license agreement. 
*******************************************************************************/
/*******************************************************************************
* Contains function declarations and macros used in the main file
*******************************************************************************/
#if !defined(MAIN_H)
#define MAIN_H
#include "stdio.h"
#include <project.h>
#include "BLEProcess.h"
#include "ble_ad5933.h"	
#include "ad5933.h"
#include "iic_hal.h"
    #include "UART_DEB_SPI_UART.h"
/********************************** Macors ******************************************/
/* General Macros*/
#define TRUE							0x01
#define FALSE							0x00
/******************************************************************************************/

    /***************************************
* Conditional Compilation Parameters
***************************************/
#define DEBUG_UART_ENABLED              ENABLED


    
/******************************* Function Declaration *************************************/
void InitializeSystem(void);
/********************************************************************************************/

/***************************************
*        Macros
***************************************/
#if (DEBUG_UART_ENABLED == ENABLED)
    #define DBG_PRINTF(...)          (printf(__VA_ARGS__))
    #define Report(...) (printf(__VA_ARGS__))
#else
    #define DBG_PRINTF(...)
#endif /* (DEBUG_UART_ENABLED == ENABLED) */


#endif

/* [] END OF FILE */
