ashtonchase/portable_impedance_tomography/software/PSOC/Workspace/AD5933_PSOC.cydsn/debug.c

/*******************************************************************************
* File Name: debug.c
*
* Version: 1.0
*
* Description:
*  This file contains functions for printf functionality.
*
* Hardware Dependency:
*  CY8CKIT-042 BLE
*
********************************************************************************
* Copyright 2016, Cypress Semiconductor Corporation.  All rights reserved.
* You may use this file only in accordance with the license, terms, conditions,
* disclaimers, and limitations in the end user license agreement accompanying
* the software package with which this file was provided.
*******************************************************************************/

#include "main.h"

#if (DEBUG_UART_ENABLED == ENABLED)


/* For GCC compiler revise _write() function for printf functionality */
int _write(int file, char *ptr, int len)
{
    int i;
    file = file;
    for (i = 0; i < len; i++)
    {
        UART_DEB_UartPutChar(*ptr++);
        
    }
    return len;
}



int puts(const char *s){
    
 UART_DEB_UartPutString(s);

return 0;
}

#endif /* DEBUG_UART_ENABLED == ENABLED */


/* [] END OF FILE */
