ashtonchase/portable_impedance_tomography/(commit log)

2017-09-07 added PowerPoint Format to documentation.
2017-09-11 added kicad files
    [ad5933.sch, ctrl_if.sch, front_end.sch, portable_imedance.kicad_pcb, portable_imedance.sch, power.sch, rx_mux.sch, tx_mux.sch]
2017-10-14 pcb design updates. updated README. updated mid_term presentation.
    [ad5933.sch, ctrl_if.sch, front_end.sch, portable_imedance.kicad_pcb, portable_imedance.sch, power.sch, rx_mux.sch]
2017-10-14 added pictures of PCB.
2017-10-18 update board to include additional connector
    [auxconn.sch]
2017-10-18 updated board to include aux connector
    [ad5933.sch, front_end.sch, portable_imedance.kicad_pcb, portable_imedance.sch, power.sch, rx_mux.sch]
2017-10-19 added kicad-library submodule to repository to prepare for handling library dependencies.
2017-10-19 Added BOM specific materials
    [portable_imedance.xlsx]
2017-10-22 final project updates. BOM updates.
    [ad5933.sch, auxconn.sch, front_end.sch, portable_imedance.sch, portable_imedance.xlsx, power.sch, rx_mux.sch]
2017-12-02 updated psoc component APIs. had to update I2C functions as such to include timeouts. also the I2C Read Byte command changed.
