ashtonchase/portable_impedance_tomography/(notices)

Notices in the files:
documentation/report/report.tex:
This work is distributed under the LaTeX Project Public License (LPPL)
